hamuro80/deepstomp/hardware/deepstomp-cpu-board-stm32f1-blue-pill.png

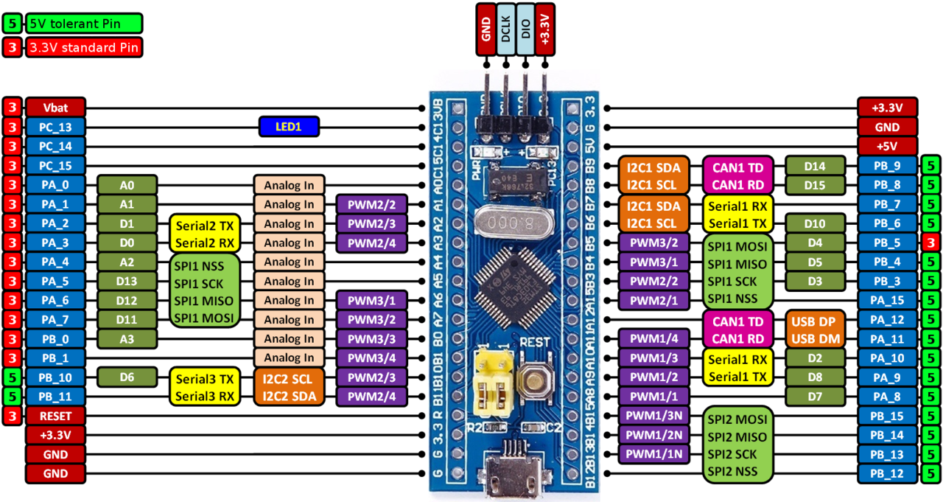
hardware/deepstomp-cpu-board-stm32f1-blue-pill.png
