hamuro80/deepstomp/hardware/deepstomp-main-board-schematic-1.2.png

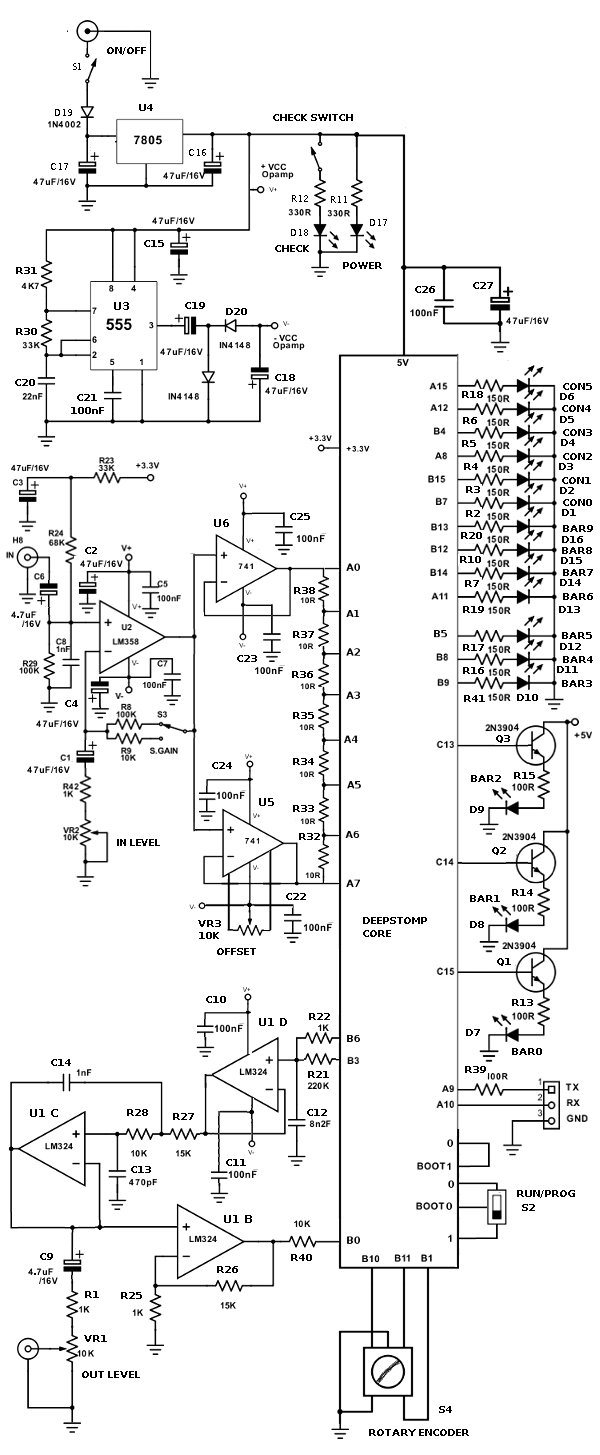
hardware/deepstomp-main-board-schematic-1.2.png
