hamuro80/deepstomp/software/deepstomp/Src/main.c

/**
  ******************************************************************************
  * @file           : main.c
  * @brief          : Main program body
  ******************************************************************************
  ** This notice applies to any and all portions of this file
  * that are not between comment pairs USER CODE BEGIN and
  * USER CODE END. Other portions of this file, whether 
  * inserted by the user or by software development tools
  * are owned by their respective copyright owners.
  *
  * COPYRIGHT(c) 2019 STMicroelectronics
  *
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
  ******************************************************************************
  */
/* Includes ------------------------------------------------------------------*/
#include "main.h"
#include "stm32f1xx_hal.h"

/* USER CODE BEGIN Includes */
/**
  ******************************************************************************
  * @file           : main.c
  * @brief          : Main core of DeepStomp program
  ******************************************************************************
  ** This notice applies to any and all portions of this file
  * that are  IN BETWEEN comment pairs USER CODE BEGIN and
  * USER CODE END. Other portions of this file, whether
  * inserted by the user or by software development tools
  * are owned by their respective copyright owners.
  *
  * Author: HAMURO
  * COPYRIGHT(c) 2018 DEEPTRONIC.COM
  *
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
  ******************************************************************************
  */
#include "deepstomp.h"
#include "dstlib_leveldetector.h"
#include "dstlib_dcremover.h"

//ENUMERATED CONSTANTS
enum {dsdisplaytype_bar, dsdisplaytype_dot, dsdisplaytype_blinkdot,dsdisplaytype_blinkbar,dsdisplaytype_semitones};
enum {editexit_expired,editexit_click,editexit_longpress,
	editexit_storepresetexpired,editexit_storepresetclick,
	editexit_storepresetlongpress};

//ERROR BLINK CODES
#define ERR_TOO_MANY_CAL_TRIALS	2
#define ERR_TOO_LOW_RESISTOR	3
#define ERR_TOO_HIGH_RESISTOR	4
#define ERR_STORAGE_ALLOCATION	5
#define ERR_MODULE_SETUP		6
#define ERR_DEBUGMON_INIT		7

//ROTARY
#define ROT_SW_Pin GPIO_PIN_1
#define ROT_SW_GPIO_Port GPIOB

#define ROT_PH_1_Pin GPIO_PIN_10
#define ROT_PH_1_GPIO_Port GPIOB
#define ROT_PH_0_Pin GPIO_PIN_11
#define ROT_PH_0_GPIO_Port GPIOB

//PARAMS LED
#define LED_INDI_0_Pin GPIO_PIN_7
#define LED_INDI_0_GPIO_Port GPIOB
#define LED_INDI_1_Pin GPIO_PIN_15
#define LED_INDI_1_GPIO_Port GPIOB
#define LED_INDI_2_Pin GPIO_PIN_8
#define LED_INDI_2_GPIO_Port GPIOA
#define LED_INDI_3_Pin GPIO_PIN_4
#define LED_INDI_3_GPIO_Port GPIOB
#define LED_INDI_4_Pin GPIO_PIN_12
#define LED_INDI_4_GPIO_Port GPIOA
#define LED_INDI_5_Pin GPIO_PIN_15
#define LED_INDI_5_GPIO_Port GPIOA

//LED BAR
#define LED_BAR_0_Pin GPIO_PIN_15
#define LED_BAR_0_GPIO_Port GPIOC
#define LED_BAR_1_Pin GPIO_PIN_14
#define LED_BAR_1_GPIO_Port GPIOC
#define LED_BAR_2_Pin GPIO_PIN_13
#define LED_BAR_2_GPIO_Port GPIOC
#define LED_BAR_3_Pin GPIO_PIN_9
#define LED_BAR_3_GPIO_Port GPIOB
#define LED_BAR_4_Pin GPIO_PIN_8
#define LED_BAR_4_GPIO_Port GPIOB
#define LED_BAR_5_Pin GPIO_PIN_5
#define LED_BAR_5_GPIO_Port GPIOB
#define LED_BAR_6_Pin GPIO_PIN_11
#define LED_BAR_6_GPIO_Port GPIOA
#define LED_BAR_7_Pin GPIO_PIN_14
#define LED_BAR_7_GPIO_Port GPIOB
#define LED_BAR_8_Pin GPIO_PIN_12
#define LED_BAR_8_GPIO_Port GPIOB
#define LED_BAR_9_Pin GPIO_PIN_13
#define LED_BAR_9_GPIO_Port GPIOB

//maximum CPU clock count for sample to sample acquisition
#define MAXCPUCOUNT	1632
//maximum CPU clock count for single sample processing to indicate CPU overload
#define MAXPROCESSINGCOUNT	1450
//CPU OVERLOAD DETECTOR
static uint8_t cpuoverload = 0;
static uint8_t cpuoverloadcounter = 0;

//ADC calibration
uint8_t CALIBRATIONMODE = 0;
//32766 + 128
#define maxcalsignallevel 32894
//32766 - 128
#define mincalsignallevel 32638
#define calsignalstep 2
//difference between onechannel and allchannel = 896
#define standarddiff 	896

//ADC calibration data
typedef struct
{
	uint16_t calsignalcurrlevel;
	int8_t calsignalstate;
	uint32_t allchannelsum ;
	uint32_t onechannelsum ;
	uint32_t onechannelsample;
	uint32_t allchannelsample;

	int8_t prevcalsignalstate;
	uint16_t mincalsample;
	uint16_t maxcalsample;
	uint16_t avgrange;
	uint32_t rangesum;
	uint32_t diffsum;
	int16_t diffavg;
	int avgcount;
} adccaldata;

typedef struct
{
	int32_t storagecounter;
	int8_t params[6];
	int8_t presetbuffer[800];	//4 params * 10 modules * 20 presets = 800
} storagestruct;

//preset data structure element
typedef struct
{
	int8_t control[4];
} controlarray;

//preset data structure element
typedef struct
{
	controlarray module[10];
} modulearray;

typedef struct
{
	modulearray preset[19];
} preset;

//debug monitor data
typedef struct
{
	char txbuff[533];
	char rxbuff[40];
	int rxbuffindex;
	int rxbuffsize;
	unsigned char rxchar;
	char* display;
	char* debugtext;
	int displaysize;
	char linebuffer[51];
	volatile uint8_t serialtxcomplete;
	long int debugvars[4];

	q15_t levelprobes[2];
	q15_t levelout[2];
	dst_leveldetector_handle levelprobe1;
	dst_leveldetector_handle levelprobe2;

	uint32_t run_prevtick;
	uint32_t run_currtick;

} debugmonitor;


enum {tunerfillstate_start,tunerfillstate_waitlow,tunerfillstate_waitrising,
	tunerfillstate_waitfalling,tunerfillstate_waitsecondrising,
	tunerfillstate_placetobin,tunerfillstate_findthenote,tunerfillstate_idle};
//Scaled 8x (one-period sample count)  of C to B semitone notes (65.41Hz - 123.47Hz)
uint32_t const periodcountcenter8x[] =
{5394,5091,4805,4536,4281,4041,3814,3600,3398,3207,3027,2857};

//period count at semitone boundary
uint32_t const periodcountboundary8x[] =
{5552,5240,4946,4669,4407,4159,3926,3706,3498,3301,3116,2941,2776};

typedef struct
{
	uint8_t detectednote;
	int8_t notedeviation;
	uint8_t audiomute;
	uint32_t periodcounter;
	uint32_t previousperiod;
	uint32_t accumulatedperiod;
	uint16_t accumulatedcycle;
	uint16_t nosignalcounter;
	uint8_t fillstate;
	uint16_t detectionlength;
	q15_t positivethreshold;
	q15_t negativethreshold;
	uint16_t peakdetectcounter;
	uint8_t peakdetectstate;
	q15_t pospeak0;
	q15_t pospeak1;
	q15_t negpeak0;
	q15_t negpeak1;
	uint32_t run_prevtick;
	uint32_t run_currtick;
	uint8_t run_state;
} instrumenttuner;

/* USER CODE END Includes */

ADC_HandleTypeDef hadc1;
ADC_HandleTypeDef hadc2;
DMA_HandleTypeDef hdma_adc1;

TIM_HandleTypeDef htim1;
TIM_HandleTypeDef htim2;
TIM_HandleTypeDef htim3;
TIM_HandleTypeDef htim4;

UART_HandleTypeDef huart1;
DMA_HandleTypeDef hdma_usart1_tx;

/* USER CODE BEGIN PV */
//Debug monitor
debugmonitor* dmon;

	//double pwm calibration variables
	uint16_t histep=0;
	uint16_t lostep=0;
	int calibcount=0;


	//ADC calibration data
	adccaldata* caldata;

	//musical instrument  tuner
	instrumenttuner* tuner;
	uint8_t tunermode = 0;

	//audio input-output variables
	q15_t INPUTLEVEL;	//the detected input level before any processing by effect application
	uint16_t adcbuffer[16];
	q15_t insample=0;
	q15_t outsample=0;
	int adccounter=0;
	uint16_t cpucount=0;
	q15_t paramlevel;
	dst_leveldetector_handle leveldetector;
	dst_dcremover_handle dcremover;
	uint32_t RUNTIME=0;

	//parameter edit control
	//handle of the edited module (PARAMS[0]-PARAMS[3] in multi-effect mode
	dsthandle SUBMODULE;
	dstparam* PARAMS[6];	//The attached parameters (to be rotated and edited)
	int8_t EDITEXITSTATUS;	//the status of PARAMS edit mode exit
	static int8_t paramindex;
	static int8_t presettostore;
	static paramchangecall ROTATE_CALLBACK = 0;
	static uint32_t ROTATEDMODULE = 0;
	dstparam paramdump;

	//parameter saving variables
	//assume a 64k flash memory, use the last four pages  for params and presets storage (page address 0x800f00 to 0x800fc00)
	uint32_t* storagepageaddress[] = {(uint32_t*)0x800f000,(uint32_t*)0x800f400,(uint32_t*)0x800f800,(uint32_t*)0x800fc00};
	storagestruct* storagebuffer;
	int activepageindex;
	int32_t storagecounter;
	int datasetlength;
	int datasetindex;
	int8_t requeststorageupdate=0;
	preset* PRESETBUFFER;	//preset buffer pointer

	//led indicator and led bar constants
	//led indicator states buffer
	uint8_t ledindibuttonstate[] = {0,0,0,0,0,0};	//when activated by toggle or radio button

const GPIO_TypeDef* ledbarport[] = {LED_BAR_0_GPIO_Port,LED_BAR_1_GPIO_Port,LED_BAR_2_GPIO_Port,
		LED_BAR_3_GPIO_Port,LED_BAR_4_GPIO_Port,LED_BAR_5_GPIO_Port,
		LED_BAR_6_GPIO_Port,LED_BAR_7_GPIO_Port,LED_BAR_8_GPIO_Port,
		LED_BAR_9_GPIO_Port};
const uint16_t ledbarpin[] = {LED_BAR_0_Pin,LED_BAR_1_Pin,LED_BAR_2_Pin,LED_BAR_3_Pin,
		LED_BAR_4_Pin,LED_BAR_5_Pin,LED_BAR_6_Pin,LED_BAR_7_Pin,
		LED_BAR_8_Pin,LED_BAR_9_Pin};
const GPIO_TypeDef* ledindiport[] = {LED_INDI_0_GPIO_Port,LED_INDI_1_GPIO_Port,
		LED_INDI_2_GPIO_Port,LED_INDI_3_GPIO_Port,LED_INDI_4_GPIO_Port,LED_INDI_5_GPIO_Port};
const uint16_t ledindipin[] = {LED_INDI_0_Pin,LED_INDI_1_Pin,LED_INDI_2_Pin,
		LED_INDI_3_Pin,LED_INDI_4_Pin,LED_INDI_5_Pin};

/* USER CODE END PV */

void SystemClock_Config(void);
static void MX_GPIO_Init(void);
static void MX_DMA_Init(void);
static void MX_ADC1_Init(void);
static void MX_ADC2_Init(void);
static void MX_TIM3_Init(void);
static void MX_USART1_UART_Init(void);
static void MX_TIM4_Init(void);
static void MX_TIM2_Init(void);
static void MX_TIM1_Init(void);

void HAL_TIM_MspPostInit(TIM_HandleTypeDef *htim);
                                

/* USER CODE BEGIN PFP */
static void errorhalt(int blinkcount);
static void errorblink(int blinkcount);
static uint16_t generatecalsignal();
static void runcalibrationdisplay();
static int debugmonitor_init();
static void debugmonitor_run();
static void debugdisplay(char* string, int line);
void createleveprobe(char* buff,q15_t level,char* label);
void adccal_init();
void tuner_init();
void tuner_fillnotebins(q15_t* input);
void tuner_detectpeak(q15_t* input);
void tuner_run();


/* USER CODE END PFP */

/* USER CODE BEGIN 0 */

enum {tuner_runstate_start,tuner_runstate_waitfill,tuner_runstate_setdisplay};
void tuner_run()
{
	tuner->run_currtick = HAL_GetTick();
	if((tuner->run_currtick - tuner->run_prevtick) < 2) // execute every 2 milliseconds
		return;

	tuner->run_prevtick = tuner->run_currtick;
	switch(tuner->run_state)
	{
		case tuner_runstate_start:
		{
			tuner->fillstate = tunerfillstate_start;
			tuner->run_state = tuner_runstate_waitfill;
			break;
		}
		case tuner_runstate_waitfill:
		{
			if(tuner->fillstate == tunerfillstate_idle)
				tuner->run_state = tuner_runstate_setdisplay;
			break;
		}
		case tuner_runstate_setdisplay:
		{
			if(tuner->accumulatedcycle > 0)
			{
				int32_t averageperiod = (tuner->accumulatedperiod<<3)/ tuner->accumulatedcycle;

				//normalize the period to the standard octave
				while(averageperiod > periodcountboundary8x[0])
					averageperiod = averageperiod >> 1;
				while(averageperiod < periodcountboundary8x[12])
					averageperiod = averageperiod << 1;

				for(uint8_t i=1;i<13;i++)
				{
					if(averageperiod > periodcountboundary8x[i])
					{
						tuner->detectednote = i-1;
						break;
					}
				}
				debugSetVar(averageperiod,0);
				debugSetVar(tuner->accumulatedcycle,1);
				debugSetVar(tuner->detectednote,2);

				//set the deviation display
				tuner->notedeviation = 0;
				int32_t ndev = averageperiod - periodcountcenter8x[tuner->detectednote];
				int downstep = (periodcountboundary8x[tuner->detectednote]-
								periodcountcenter8x[tuner->detectednote])/3;
				int upstep = (periodcountcenter8x[tuner->detectednote]
								- periodcountboundary8x[1+tuner->detectednote])/3;

				//translate the detected note to differentiate mute and unmuted operation
				if(tuner->audiomute)
					tuner->detectednote += 12;
				else tuner->detectednote += 24;

				//first turn off all note deviation indicator leds
				for(int i=0;i<6;i++)
					ledindibuttonstate[i]=0;

				//if deviate above the center frequency
				if(ndev < 0)
				{
					int upindex = -ndev/downstep;
					if(upindex >2) upindex = 2;
					ledindibuttonstate[3+upindex]=1;

					//if only slightly above the center
					if(ndev > (- upstep>>1))
						ledindibuttonstate[2]=1;

				}
				else if(ndev>0) //if deviate below the center frequency
				{
					int downindex = ndev/downstep;
					if(downindex >2) downindex = 2;
					ledindibuttonstate[2-downindex]=1;

					//if only slightly above the center
					if(ndev < (upstep>>1))
						ledindibuttonstate[3]=1;
				}
				else	//if not deviate
				{
					ledindibuttonstate[3]=1;
					ledindibuttonstate[2]=1;
				}

				//reset nosignal counter
				tuner->nosignalcounter = 0;

			}
			else	//no signal detected
			{
				//turn off all note deviation indicator leds
				if(tuner->nosignalcounter<11)
					tuner->nosignalcounter++;
				if(tuner->nosignalcounter>5) //more than 1 second
				{
					for(int i=0;i<6;i++)
					{
						ledindibuttonstate[i]=0;
					}
				}
			}

			tuner->run_state = tuner_runstate_start;
			break;
		}
	}
}

void tuner_init()
{
	tuner = malloc(sizeof(tuner));
	tuner->detectednote = 24;
	tuner->notedeviation = -4;
	tuner->audiomute = 0;
	tuner->run_state = tuner_runstate_start;
	tuner->run_prevtick = 0;
	tuner->run_prevtick = 0;
	tuner->fillstate = tunerfillstate_idle;
	tuner->peakdetectcounter = 0;
	tuner->peakdetectstate = 0;
	tuner->pospeak0 = 0;
	tuner->pospeak1 = 0;
	tuner->negpeak0 = 0;
	tuner->negpeak1 = 0;
	tuner->nosignalcounter = 0;
}

void tuner_detectpeak(q15_t* input)
{
	tuner->peakdetectcounter++;
	q15_t positivepeak,negativepeak;
	if(tuner->peakdetectstate == 0)
	{
		if((*input)>tuner->pospeak0) tuner->pospeak0 = (*input);
		if((*input)<tuner->negpeak0) tuner->negpeak0 = (*input);
		if(tuner->peakdetectcounter > 2205)
		{
			tuner->peakdetectcounter = 0;
			tuner->peakdetectstate = 1;
			if(tuner->pospeak0 > tuner->pospeak1)
				positivepeak = tuner->pospeak0;
			else positivepeak = tuner->pospeak1;
			if(tuner->negpeak0 < tuner->negpeak1)
				negativepeak = tuner->negpeak0;
			else negativepeak = tuner->negpeak1;

			tuner->positivethreshold = (q15_t) ((q31_t)(positivepeak << 3)/10);
			tuner->negativethreshold = (q15_t) ((q31_t)(negativepeak << 3)/10);

			tuner->pospeak1 = 0;
			tuner->negpeak1 = 0;


		}
	}
	else
	{
		if((*input)>tuner->pospeak1) tuner->pospeak1 = (*input);
		if((*input)<tuner->negpeak1) tuner->negpeak1 = (*input);
		if(tuner->peakdetectcounter > 2205)
		{
			tuner->peakdetectcounter = 0;
			tuner->peakdetectstate = 0;

			//select the maximum minimum
			if(tuner->pospeak0 > tuner->pospeak1)
				positivepeak = tuner->pospeak0;
			else positivepeak = tuner->pospeak1;
			if(tuner->negpeak0 < tuner->negpeak1)
				negativepeak = tuner->negpeak0;
			else negativepeak = tuner->negpeak1;

			tuner->positivethreshold = (q15_t) ((q31_t)(positivepeak << 3)/10);
			tuner->negativethreshold = (q15_t) ((q31_t)(negativepeak << 3)/10);

			//reset the variable for the next phase
			tuner->pospeak0 = 0;
			tuner->negpeak0 = 0;
		}
	}
}

void tuner_fillnotebins(q15_t* input)
{
	tuner_detectpeak(input);
	switch(tuner->fillstate)
	{
		case tunerfillstate_start:
		{
			tuner->detectionlength = 0;
			tuner->accumulatedcycle = 0;
			tuner->accumulatedperiod = 0;
			tuner->negativethreshold = 0;
			tuner->positivethreshold = 0;
			tuner->fillstate = tunerfillstate_waitlow;
			break;
		}
		case tunerfillstate_waitlow:
		{
			if((tuner->positivethreshold > 500) && ((*input)<0))
				tuner->fillstate = tunerfillstate_waitrising;
			break;
		}
		case tunerfillstate_waitrising:
		{
			if((*input)>tuner->positivethreshold)
			{
				tuner->periodcounter = 0;
				tuner->fillstate = tunerfillstate_waitfalling;
			}
			break;
		}
		case tunerfillstate_waitfalling:
		{
			tuner->periodcounter++;
			if((*input) < tuner->negativethreshold)
				tuner->fillstate = tunerfillstate_waitsecondrising;
			break;
		}
		case tunerfillstate_waitsecondrising:
		{
			tuner->periodcounter++;
			if((*input) > tuner->positivethreshold)
			{
				//filter the detected period
				//if periodcounter differs not more than on semitone than previous then
				//accumulate the period and update the previous with the new period
				//if differs more that one semitones (6%) then update the previous with
				//the new one and discard the mesured period

				//if between 20-2000Hz
				if((tuner->periodcounter > 20)&&(tuner->periodcounter<2200))
				{
					int32_t perioddiff ;
					if(tuner->periodcounter > tuner->previousperiod)
							perioddiff = (tuner->periodcounter - tuner->previousperiod)<<10;
					else  perioddiff = (tuner->previousperiod - tuner->periodcounter)<<10;

					if((perioddiff/tuner->previousperiod) <= 61)	//if not differ more than one semitone
					{
						tuner->accumulatedcycle++;
						tuner->accumulatedperiod += tuner->periodcounter;
					}
					tuner->previousperiod = tuner->periodcounter;
				}

				//reset period counter
				tuner->periodcounter = 0;
				tuner->fillstate = tunerfillstate_waitfalling;
			}
			break;
		}
		case tunerfillstate_idle:
		{
			break;
		}

	}

	if(tuner->fillstate != tunerfillstate_idle)
		tuner->detectionlength++;
	if(tuner->detectionlength > 8820)	// more than 0.2 seconds
		tuner->fillstate = tunerfillstate_idle; //stop the detection
}

int debugmonitor_init()
{
	dmon = malloc(sizeof(debugmonitor));
	if(dmon==NULL)
		return ERR_DEBUGMON_INIT;
	dmon->txbuff[0]=27;
	dmon->txbuff[1] ='[';
	dmon->txbuff[2] = 'H';
	dmon->display = &(dmon->txbuff[3]);
	dmon->debugtext = "DEBUG TEXT";
	dmon->serialtxcomplete = 1;
	dmon->rxbuffindex = 0;
	dmon->rxbuffsize = 40;
	dmon->displaysize = 530;

	for(int i=3;i<533;i++)
	{
		dmon->txbuff[i]=' ';
	}
	dmon->txbuff[532]=0;

	for(int i=50;i<530;i++)
	{
	  if((i%53)==0)
	  {
		  dmon->display[i-2]='\n';
		  dmon->display[i-1]='\r';
	  }
	}

	debugdisplay("DEEPSTOMP PEDAL PROCESSOR DEBUG MONITOR",0);
	if(USE_LEVEL_MONITOR)
	{
		dmon->levelprobe1 = dst_leveldetector_create(4410);
		dmon->levelprobe2 = dst_leveldetector_create(4410);
	}
	return 0;
}

static void debugdisplay(char* string, int line)
{
	if(line>9)
		return;
	char* dest = &(dmon->display[53*line]);
	strncpy(dest,string,50);
	int len = strlen(string);
	if(len>50)
		len=50;
	for(int i=len;i<50;i++)
		dest[i]=' ';	//overwrite the old data with space
}

void debugSetText(char* text)
{
	if(USE_DEBUG_MONITOR)
	{
		dmon->debugtext = text;
	}
}

void debugmonitor_run()
{
	dmon->run_currtick = HAL_GetTick();
	if(dmon->run_currtick-dmon->run_prevtick<100)
	  return;
	dmon->run_prevtick = dmon->run_currtick;
	int sr = adccounter * 10;
	adccounter = 0;

	snprintf(dmon->linebuffer,51,"Run: %d s, sfreq: %d, storage cycles: %ld",(int)dmon->run_currtick/1000,sr,storagecounter);
	debugdisplay(dmon->linebuffer,1);
	snprintf(dmon->linebuffer,51,"CAL (Hi: %d, Low: %d, ARR2: %d, Trial: %d)",(int)histep,(int)lostep,(int)TIM2->ARR,(int)calibcount);
	debugdisplay(dmon->linebuffer,2);
	if(cpucount==0)	//CPU overload
		snprintf(dmon->linebuffer,51,"Module CPU: OVERLOAD");
	else
	{
		snprintf(dmon->linebuffer,51,"Module CPU: %d%%",100*cpucount/MAXCPUCOUNT);
	}
	debugdisplay(dmon->linebuffer,3);

	if(USE_LEVEL_MONITOR)
	{
		createleveprobe(dmon->linebuffer,INPUTLEVEL,"IN");
		debugdisplay(dmon->linebuffer,4);
		createleveprobe(dmon->linebuffer,dmon->levelout[0],"P1");
		debugdisplay(dmon->linebuffer,5);
		createleveprobe(dmon->linebuffer,dmon->levelout[1],"P2");
		debugdisplay(dmon->linebuffer,6);
		if(CALIBRATIONMODE)
			snprintf(dmon->linebuffer,51,"ADC CAL: Range, One Ch., All Ch., Diff");
		else snprintf(dmon->linebuffer,51,"DTXT: %s",dmon->debugtext);
		debugdisplay(dmon->linebuffer,7);
		snprintf(dmon->linebuffer,51,"DVAR: %ld, %ld, %ld, %ld",
		  dmon->debugvars[0],dmon->debugvars[1],
		  dmon->debugvars[2],dmon->debugvars[3]);

		debugdisplay(dmon->linebuffer,8);
	}
	else
	{
		if(CALIBRATIONMODE)
			snprintf(dmon->linebuffer,51,"ADC CAL: Range, One Ch., All Ch., Diff");
		else snprintf(dmon->linebuffer,51,"DTXT: %s",dmon->debugtext);
		debugdisplay(dmon->linebuffer,4);
		snprintf(dmon->linebuffer,51,"DVAR: %ld,%ld, %ld, %ld",
		  dmon->debugvars[0],dmon->debugvars[1],
		  dmon->debugvars[2],dmon->debugvars[3]);
		debugdisplay(dmon->linebuffer,5);
	}

	//return if DMA transfer is still working
	if(dmon->serialtxcomplete == 0)
	  return;
	//reset the flag and start DMA transmit
	dmon->serialtxcomplete = 0;
	HAL_UART_Transmit_DMA(&huart1,(uint8_t*)dmon->txbuff,512);
}

void debugSetVar(int32_t var, uint8_t index)
{
	if(index>3)index = 3;
	if(USE_DEBUG_MONITOR)
	{
		dmon->debugvars[index]=var;
	}
}
void debugDetectLevel(q15_t signal, uint8_t channel)
{
	dmon->levelprobes[channel] = signal;
}

void adccal_init()
{
	caldata = malloc(sizeof(caldata));
	caldata->allchannelsum=0;
	caldata->avgcount = 0;
	caldata->avgrange = 0;
	caldata->calsignalcurrlevel = mincalsignallevel;
	caldata->calsignalstate = 1;
	caldata->diffavg = 0;
	caldata->diffsum = 0;
	caldata->maxcalsample = 0;
	caldata->mincalsample = 65000;
	caldata->onechannelsum = 0;
	caldata->prevcalsignalstate = 1;
	caldata->rangesum = 0;
}

static void runcalibrationdisplay()
{
	// if the sawtooth generator change the direction from down ramp to up ramp
	// (changes every 128 steps, 64 steps up and 64 steps down)
	// the input might have a phase shift but it would always be a complete cycle
	if((caldata->calsignalstate==1)&&(caldata->prevcalsignalstate==0))
	{
		caldata->rangesum += (caldata->maxcalsample-caldata->mincalsample);	//sums for averaging
		caldata->diffsum += caldata->allchannelsum-caldata->onechannelsum;		//difference between all and one channel
		caldata->avgcount++;
		if(caldata->avgcount==128)
		{
			caldata->avgrange = caldata->rangesum >> 7;	//the average range should 128 if the i/o level is properly adjusted
			caldata->rangesum = 0;
			caldata->avgcount = 0;
			caldata->diffavg = (int16_t) ( caldata->diffsum >> 7);
			/*the average difference between all and one channel should be 896
			 * when the all channel is produced by 15bit ADC and the one channel is produced by (12bit_ADC << 3)
			 */
			caldata->diffsum = 0;
		    if(USE_DEBUG_MONITOR)
		    {
		    	dmon->debugvars[0] = (int) caldata->avgrange;
		    	dmon->debugvars[1] = (int) caldata->onechannelsum;
				dmon->debugvars[2] = (int) caldata->allchannelsum;
				dmon->debugvars[3] = (int) caldata->diffavg;
		    }
		}

		//display avgrange on the 6-LED-bar, diffavg=128 for the center point
		//activate 2-LEDs only for the center point
	    int insignalindex = (caldata->avgrange>>3)-14;
	    if(insignalindex < 0) insignalindex = 0;
	    if(insignalindex > 4) insignalindex = 4;
	    for(int i = 0;i<5;i++)
	    {
	    	int offset = 0;
	    	if(i>=3) offset = 1;
	    	HAL_GPIO_WritePin((GPIO_TypeDef*)ledindiport[i+offset],ledindipin[i+offset],i==insignalindex);
	    	if(i==2)
	    		HAL_GPIO_WritePin((GPIO_TypeDef*)ledindiport[3],ledindipin[3],i==insignalindex);
	    }

	    //display diffavg on the 10-LED-bar, diffavg=896 for the center point
	    //activate 2-LEDs only for the center point
	    insignalindex = ( caldata->diffavg >> 7 ) - 3;
		if(insignalindex < 0) insignalindex = 0;
		if(insignalindex > 9) insignalindex = 8;
		for(int i = 0;i<9;i++)
		{
			int offset = 0;
			if(i>=5) offset = 1;
			HAL_GPIO_WritePin((GPIO_TypeDef*)ledbarport[i+offset],ledbarpin[i+offset],i==insignalindex);
			if(i==4)
				HAL_GPIO_WritePin((GPIO_TypeDef*)ledbarport[5],ledbarpin[5],i==insignalindex);
		}

		caldata->onechannelsum = 0;
		caldata->allchannelsum = 0;
		caldata->mincalsample = 65534;
		caldata->maxcalsample = 0;
	}

	caldata->prevcalsignalstate = caldata->calsignalstate;
	if(caldata->onechannelsample > caldata->maxcalsample)
		caldata->maxcalsample = caldata->onechannelsample;
	if(caldata->onechannelsample < caldata->mincalsample)
		caldata->mincalsample = caldata->onechannelsample;

}


void loadfromstorage()
{
	//read the flash memory
	uint32_t* bufferptr = (uint32_t*) storagebuffer;

	storagecounter = 0;
	int maxindex = 0;
	for(int i=0;i<4;i++)
	{
		int32_t* counterptr = (int32_t*)storagepageaddress[i];
		if(counterptr[0] > storagecounter)
		{
			storagecounter = counterptr[0];
			maxindex = i;
		}
	}
	activepageindex = maxindex;

	//load from maxindex page
	uint32_t* storageptr = storagepageaddress[maxindex];
	for(uint16_t i=0;i<256;i++)
	{
		bufferptr[i] = storageptr[i];
	}
}

void writetostorage()
{
	requeststorageupdate=1;
}

uint32_t storagewrite_currtick = 0;
uint32_t storagewrite_prevtick = 0;
int storagewriteindex;
enum {writestate_wait,writestate_selectpage,writestate_erase,writestate_program};
uint8_t writestate = writestate_wait;
static void runstoragewrite()
{
	storagewrite_currtick = HAL_GetTick();
	if(storagewrite_currtick-storagewrite_prevtick<10)
		return;
	storagewrite_prevtick = storagewrite_currtick;

	switch(writestate)
	{
		case writestate_wait:
		{
			if(requeststorageupdate)
			{
				requeststorageupdate=0;
				storagewriteindex = 0;
				writestate= writestate_selectpage;
			}
			break;
		}
		case writestate_selectpage:
		{
			//unlock the flash
			HAL_FLASH_Unlock();

			uint32_t* data = (uint32_t*) storagebuffer;
			storagecounter++;
			data[0] = storagecounter;

			//select the next page for the next storage to increase total storage durability
			activepageindex++;
			if(activepageindex>3)
				activepageindex = 0;
			writestate = writestate_erase;
			break;
		}
		case writestate_erase:
		{
			//erase the page
			FLASH_EraseInitTypeDef eraseinit;
			eraseinit.PageAddress = (uint32_t)storagepageaddress[activepageindex];
			eraseinit.Banks = FLASH_BANK_1;
			eraseinit.NbPages = 1;
			eraseinit.TypeErase = FLASH_TYPEERASE_PAGES;
			uint32_t pageerror;
			HAL_FLASHEx_Erase(&eraseinit,&pageerror);
			writestate = writestate_program;
			break;
		}
		case writestate_program:
		{
			//write the page
			uint32_t* data = (uint32_t*) storagebuffer;
			HAL_FLASH_Program(FLASH_TYPEPROGRAM_WORD,(uint32_t) &(storagepageaddress[activepageindex][storagewriteindex]),(uint64_t)data[storagewriteindex]);

			//increment the index and lock the page if done
			storagewriteindex++;
			if(storagewriteindex==256)
			{
				HAL_FLASH_Lock();
				writestate = writestate_wait;
			}
			break;
		}
	}

}

static void errorhalt(int blinkcount)
{
	//turn off all LEDs
	for(int i=0;i<6;i++)
	{
		HAL_GPIO_WritePin((GPIO_TypeDef*)ledbarport[i],ledindipin[i],0);
	}
	for(int i=0; i<10; i++)
	{
		HAL_GPIO_WritePin((GPIO_TypeDef*)ledbarport[i],ledbarpin[i],0);
	}

	//long 2 seconds fast blinks first
	for(int i=0;i<20;i++)
	{
		HAL_GPIO_WritePin((GPIO_TypeDef*)ledindiport[0],ledindipin[0],1);
		HAL_Delay(50);
		HAL_GPIO_WritePin((GPIO_TypeDef*)ledindiport[0],ledindipin[0],0);
		HAL_Delay(50);
	}

	//period
	HAL_Delay(1000);

	//then blink forever
	while(1)
	{
		for(int i=0;i<blinkcount;i++)
		{
			HAL_GPIO_WritePin((GPIO_TypeDef*)ledindiport[0],ledindipin[0],1);
			HAL_Delay(250);
			HAL_GPIO_WritePin((GPIO_TypeDef*)ledindiport[0],ledindipin[0],0);
			HAL_Delay(250);
		}
		HAL_Delay(500);
	}
}

static void errorblink(int blinkcount)
{
	//turn off all LEDs
	for(int i=0;i<6;i++)
	{
		HAL_GPIO_WritePin((GPIO_TypeDef*)ledbarport[i],ledindipin[i],0);
	}
	for(int i=0; i<10; i++)
	{
		HAL_GPIO_WritePin((GPIO_TypeDef*)ledbarport[i],ledbarpin[i],0);
	}

	//long 2 seconds fast blinks first
	for(int i=0;i<20;i++)
	{
		HAL_GPIO_WritePin((GPIO_TypeDef*)ledindiport[0],ledindipin[0],1);
		HAL_Delay(50);
		HAL_GPIO_WritePin((GPIO_TypeDef*)ledindiport[0],ledindipin[0],0);
		HAL_Delay(50);
	}

	//period
	HAL_Delay(1000);

	//then blinks the error code
	for(int i=0;i<blinkcount;i++)
	{
		HAL_GPIO_WritePin((GPIO_TypeDef*)ledindiport[0],ledindipin[0],1);
		HAL_Delay(500);
		HAL_GPIO_WritePin((GPIO_TypeDef*)ledindiport[0],ledindipin[0],0);
		HAL_Delay(500);
	}
}

//digital anti aliasing filter at 20kHz cut-off frequency
#define antialiasingGAIN   1259
static q31_t xv[3], yv[3];
static void antialiasing(q15_t *input, q15_t* output)
{
	xv[0] = xv[1];
	xv[1] = xv[2];
	xv[2] = ((q31_t)(*input)<<10) / antialiasingGAIN;
	yv[0] = yv[1];
	yv[1] = yv[2];
	yv[2] =   (((xv[0] + xv[2]) + 2 * xv[1])<<10)
				 + ( -678 * yv[0]) + ( -1629 * yv[1]);
	yv[2] = yv[2] >> 10;
	*output = (q15_t) yv[2];
}

static void initantialiasing()
{
	for(int i=0;i<3;i++)
	{
		xv[i]=0;
		yv[i]=0;
	}
}

GPIO_PinState  readrotsw()
{
	return HAL_GPIO_ReadPin(ROT_SW_GPIO_Port,ROT_SW_Pin);
}

GPIO_PinState  readrotp0()
{
	return HAL_GPIO_ReadPin(ROT_PH_0_GPIO_Port,ROT_PH_0_Pin);
}

GPIO_PinState  readrotp1()
{
	return HAL_GPIO_ReadPin(ROT_PH_1_GPIO_Port,ROT_PH_1_Pin);
}

int8_t rotscancount = 0;
int8_t rotsw = 1;
int8_t rotp0 = 1;
int8_t rotp1 = 1;

int8_t rotsw_sum = 0;
int8_t rotp0_sum = 0;
int8_t rotp1_sum = 0;
uint32_t rotscan_currtick = 0;
uint32_t rotscan_prevtick = 0;
void rotscan()
{
	rotscan_currtick = HAL_GetTick();
	if(rotscan_currtick-rotscan_prevtick<1)
		return;
	rotscan_prevtick = rotscan_currtick;
	rotsw_sum += (int8_t)readrotsw();
	rotp0_sum += (int8_t)readrotp0();
	rotp1_sum += (int8_t)readrotp1();
	rotscancount++;
	if(rotscancount>9)
	{
		rotscancount = 1;
		if(rotsw_sum>5) rotsw = 1; else rotsw = 0;
		if(rotp0_sum>5) rotp0 = 1; else rotp0 = 0;
		if(rotp1_sum>5) rotp1 = 1; else rotp1 = 0;
		rotsw_sum = 0;
		rotp0_sum = 0;
		rotp1_sum = 0;
	}
}

static uint8_t prevrotp0,prevrotsw;
enum {rotencode_idle,rotencode_startwaittrigger,rotencode_waittrigger,
	rotencode_startrun,rotencode_run,rotencode_waitrelease};
static uint8_t rotencode_state = rotencode_idle;
static uint32_t rotencode_currtick = 0;
static uint32_t rotencode_prevtick = 0;
uint8_t rotwaitexit = 0;
static int8_t* rotatedindex = 0;
static int8_t rotatedindexmax = 0;
static int8_t rotatetrigger = 0;
static int8_t longpresstrigger = 0;
static int8_t briefpresstrigger = 0;
enum {rotateexit_notyet,rotateexit_click,rotateexit_expired,
	rotateexit_hold,rotateexit_longpress};
static int8_t rotateexit = rotateexit_notyet;
static int rotateidle;
static int rotateholdcounter;
static int holdcounter;
static int8_t rotate_editparam = 0;

void rotencode()
{
	rotencode_currtick = HAL_GetTick();
	if(rotencode_currtick-rotencode_prevtick<10)
		return;
	rotencode_prevtick = rotencode_currtick;

	if(rotencode_state == rotencode_startwaittrigger)
	{
		rotatetrigger = 0;
		longpresstrigger = 0;
		briefpresstrigger = 0;
		if(rotp0 && rotsw)
			rotencode_state = rotencode_waittrigger;
	}
	else if(rotencode_state == rotencode_waittrigger)
	{
		if(!rotsw)	//if pressed
		{
			rotencode_state = rotencode_waitrelease;
			holdcounter = 0;
		}
		else if(rotp0 && (!prevrotp0))
		{
			rotatetrigger = 1;
			rotencode_state = rotencode_idle;
		}
	}
	else if(rotencode_state == rotencode_waitrelease)
	{
		if(!rotsw)	//if pressed
		{
			holdcounter++;
			if(holdcounter>100)
			{
				longpresstrigger = 1;
				rotencode_state = rotencode_idle;
			}
		}
		else	//if released
		{
			briefpresstrigger = 1;
			rotencode_state = rotencode_idle;
		}
	}
	else if(rotencode_state == rotencode_startrun)
	{
		rotateexit = rotateexit_notyet;
		if(rotsw && rotp0)
		{
			rotencode_state = rotencode_run;
			rotateidle = 0;
		    rotateholdcounter = 0;
		}
	}
	else if(rotencode_state == rotencode_run)
	{
		if(rotateexit == rotateexit_notyet)
		{
			if(rotsw)
			{
				if((rotp0==0)&& prevrotp0)
				{
					int8_t newval = *rotatedindex;

					if(rotp1)
					{
						newval++;
						if(newval > rotatedindexmax)
							newval = rotatedindexmax;
					}
					else
					{
						newval --;
						if(newval < 0)
							newval = 0;
					}
					rotateidle = 0;

					if(rotate_editparam)	//editing param's value
					{
						if(ROTATE_CALLBACK)
						{
							ROTATE_CALLBACK(ROTATEDMODULE,newval);
						}
						else *rotatedindex = newval;
					}
					else // selecting params
					{
						// if PARAMS[newval] has stepcount > 1 then rotatedindex = newval
						// else then increment/decrement newval until PARAMS[newval] has stepcount > 1
						// or reaching the boundary (0-5)
						if(PARAMS[newval]->stepcount > 1)
						{
							*rotatedindex = newval;
						}
						else
						{
							int direction = 1;
							if(newval < *rotatedindex)
								direction = -1;
							while(1)
							{
								if((newval == 0)||(newval == 5))
									break;

								newval = newval + direction;
								if(PARAMS[newval]->stepcount > 1)
								{
									(*rotatedindex) = newval;
									break;
								}
							}
						}

						ROTATEDMODULE = MAINMODULE;
						if(((dstinterface*)MAINMODULE)->multimode)
							if((*rotatedindex) < 4) ROTATEDMODULE = SUBMODULE;
					}

				}
				else	//no rotation
				{
					rotateidle++;
					if(rotateidle > 400)
						rotateexit = rotateexit_expired;
				}
			}
			else //rotary switch is pressed
			{
				rotateexit = rotateexit_hold;
			}

		}
		else if(rotateexit == rotateexit_hold)
		{
			if(rotsw)
			{
				if(rotateholdcounter>100)	// 1 second
				{
					rotateexit = rotateexit_longpress;
				}
				else rotateexit = rotateexit_click;
			}
			else
			{
				rotateholdcounter++;
				if(rotateholdcounter>100)
					rotateexit = rotateexit_longpress;
			}
		}
	}
	prevrotp0 = rotp0;
	prevrotsw = rotsw;
}

void HAL_ADC_ConvCpltCallback(ADC_HandleTypeDef* hadc)
{
	 TIM1->CNT = 0;
	 adccounter++;
	 if(cpucount > MAXPROCESSINGCOUNT) //CPU overload is detected on previous processing
	 {
		 cpucount = 0;
		 cpuoverload = 1;
		 return;
	 }

	 if(CALIBRATIONMODE)	//adc calibration mode
	 {
		 int32_t temp=0;
		 for(int i=8; i<16;i++)
		 {
			 temp += adcbuffer[i];
		 }

		 //record the sum of both single and multi-channel
		 caldata->onechannelsample = (((uint32_t)adcbuffer[8]) << 3);
		 caldata->onechannelsum += caldata->onechannelsample;
		 caldata->allchannelsample = temp;
		 caldata->allchannelsum += caldata->allchannelsample;

		 //run calibration display
		 runcalibrationdisplay();

		 //write calibration signal to the output
		 temp = (int32_t) generatecalsignal();
		 TIM4->CCR1 = (0xff00 & temp)>>8;
		 TIM2->CCR2 = 0xff & temp;
		 cpucount = TIM1->CNT;
	 }
	 else	//normal mode
	 {
		 int32_t temp=0;
		 for(int i=8; i<16;i++)
		 {
			 temp += adcbuffer[i];
		 }
		 //convert dc to ac signal
		 insample = (temp<<1)-32767;

		 //preprocessing the audio sample
		 q15_t nodcsignal;
		 dst_dcremover_process(dcremover,&insample,&nodcsignal);
		 dst_leveldetector_process(leveldetector,&nodcsignal,&INPUTLEVEL);
		 if(USE_DEBUG_MONITOR)
		 {
			 if(USE_LEVEL_MONITOR)
			 {
				 dst_leveldetector_process(dmon->levelprobe1,&dmon->levelprobes[0],&dmon->levelout[0]);
				 dst_leveldetector_process(dmon->levelprobe2,&dmon->levelprobes[1],&dmon->levelout[1]);
			 }
		 }

		 q15_t noaliasing;
		 antialiasing(&nodcsignal,&noaliasing);

		 if(!tunermode)
		 {
			 //processing the audio sample
			 deepstomp_process(&noaliasing,&outsample);
		 }
		 else
		 {
			tuner_fillnotebins(&noaliasing);
			if(!tuner->audiomute)
				outsample = noaliasing;
			else outsample = 0;
		 }

		 //write the sample to the output
		 temp = (int32_t) outsample + 32767; //convert outsample to dc signal
		 TIM4->CCR1 = (0xff00 & temp)>>8;
		 TIM2->CCR2 = 0xff & temp;
		 cpucount = TIM1->CNT;
	 }

}

void HAL_ADC_ConvHalfCpltCallback(ADC_HandleTypeDef* hadc)
{
	 TIM1->CNT = 0;
	 adccounter++;
	 if(cpucount > MAXPROCESSINGCOUNT) //CPU overload is detected on previous processing
	 {
		 cpucount = 0;
		 cpuoverload = 1;
		 return;
	 }

	 if(CALIBRATIONMODE)	//adc calibration mode
	 {
		 int32_t temp=0;
		 for(int i=0; i<8;i++)
		 {
			 temp += adcbuffer[i];
		 }

		 //record the sum of both single and multi-channel
		 caldata->onechannelsample = (((uint32_t)adcbuffer[0]) << 3);
		 caldata->onechannelsum += caldata->onechannelsample;
		 caldata->allchannelsample = temp;
		 caldata->allchannelsum += caldata->allchannelsample;

		 //run calibration display
		 runcalibrationdisplay();

		 //write calibration signal to the output
		 temp = (int32_t) generatecalsignal();
		 TIM4->CCR1 = (0xff00 & temp)>>8;
		 TIM2->CCR2 = 0xff & temp;
		 cpucount = TIM1->CNT;
	 }
	 else	//normal mode
	 {
		 int32_t temp=0;
		 for(int i=0; i<8;i++)
		 {
			 temp += adcbuffer[i];
		 }
		 //convert dc to ac signal
		 insample = (temp<<1)-32767;

		 //pre-processing the audio sample

		 q15_t nodcsignal;
		 dst_dcremover_process(dcremover,&insample,&nodcsignal);
		 dst_leveldetector_process(leveldetector,&nodcsignal,&INPUTLEVEL);
		 if(USE_LEVEL_MONITOR)
		 {
			 dst_leveldetector_process(dmon->levelprobe1,&dmon->levelprobes[0],&dmon->levelout[0]);
			 dst_leveldetector_process(dmon->levelprobe2,&dmon->levelprobes[1],&dmon->levelout[1]);
		 }
		 q15_t noaliasing;
		 antialiasing(&nodcsignal,&noaliasing);

		 if(!tunermode)
		 {
			 //processing the audio sample
			 deepstomp_process(&noaliasing,&outsample);
		 }
		 else
		 {
			tuner_fillnotebins(&noaliasing);
			if(!tuner->audiomute)
				outsample = noaliasing;
			else outsample = 0;
		 }

		 //write the sample to the output
		 temp = (int32_t) outsample + 32767; //convert outsample to dc signal
		 TIM4->CCR1 = (0xff00 & temp)>>8;
		 TIM2->CCR2 = 0xff & temp;
		 cpucount = TIM1->CNT;
	 }
}


void HAL_UART_TxCpltCallback (UART_HandleTypeDef * huart)
{
	if(huart == &huart1)
	{
		if(USE_DEBUG_MONITOR)
			dmon->serialtxcomplete = 1;
	}
}

void createleveprobe(char* buff,q15_t level,char* label)
{
	strncpy(buff,label,2);
	buff[2]=':';
	uint8_t x = level/819;
	for(uint8_t i=3;i<43;i++)
	{
		if((i-3) > x)
			buff[i]= ' ';
		else buff[i]= '#';
	}
	snprintf(&buff[43],8," %5d",(int)level);
}

uint16_t readcalinput()
{
	uint32_t temp=0;
	for(int i=0; i<32; i++)
	{
		HAL_ADC_Start(&hadc2);
		if(HAL_ADC_PollForConversion(&hadc2,10)==HAL_OK)
			temp += HAL_ADC_GetValue(&hadc2);
		HAL_ADC_Stop(&hadc2);
	}
	return temp>>5;
}

void calibratepwm()
{
		TIM4->ARR=256;
		TIM2->ARR=256;
		while(1)
		{
			  calibcount++;
			  if(calibcount>50)
				  break;
			  TIM4->CCR1 = 1;
			  TIM2->CCR2 = 0;
			  HAL_Delay(1);
			  uint16_t prevlevel = readcalinput();
			  histep=0;
			  lostep=0;
			  for(int a=1; a<14; a++)
			  {
				  TIM4->CCR1 = a+1;
				  TIM2->CCR2 = 0;
				  HAL_Delay(1);
				  uint16_t currentlevel = readcalinput();
				  histep += currentlevel-prevlevel;

				  TIM4->CCR1 = a;
				  TIM2->CCR2 = 0xff;
				  HAL_Delay(1);
				  lostep += readcalinput()-prevlevel;

				  prevlevel = currentlevel;
			  }

			  histep = histep/13;
			  lostep = lostep/13;

			  //predict lostep update if the difference is too large
			  if((lostep-histep)>10)
			  {
				  float newarr = (float)lostep/(float)histep * (float)TIM2->ARR;
				  TIM2->ARR = round(newarr);
			  }

			  if(lostep>=histep)
				  TIM2->ARR = TIM2->ARR+1;
			  else if(lostep < (histep-1))
				  TIM2->ARR = TIM2->ARR-1;
			  else break;
		}
}

uint8_t barstate[10];
enum {barchannel_input,barchannel_param,barchannel_presettostore,barchannel_button,
	barchannel_tuner};
uint8_t bardisplaychannel = barchannel_input;

uint8_t const semitonemainled[] = {0,0,1,1,2,3,3,4,4,5,5,6};
uint8_t const semitoneauxled[] = {0,1,1,2,2,3,4,4,5,5,6,6};

void displaybar(int8_t level, uint8_t levelcount, uint8_t type)
{
	if(levelcount<11)
	{
		if(type==dsdisplaytype_bar)
		{
			for(int i=0;i<10;i++)
			{
				if(i>level)
					barstate[i]=0;
				else barstate[i]=2;
			}
		}
		else
		if(type==dsdisplaytype_blinkbar)
		{
			for(int i=0;i<10;i++)
			{
				if(i>level)
					barstate[i]=0;
				else barstate[i]=1;
			}
		}
		else if(type==dsdisplaytype_blinkdot)
		{
			for(int i=0;i<10;i++)
			{
				if(i==level)
					barstate[i]=1;
				else barstate[i]=0;
			}
		}
		else	//dot type
		{
			for(int i=0;i<10;i++)
			{
				if(i==level)
					barstate[i]=2;
				else barstate[i]=0;
			}
		}
	}
	else if(levelcount<20)
	{
		uint8_t halflevel = level/2;
		for(int i=0;i<10;i++)
		{
			if(type==dsdisplaytype_bar)
			{
				for(int i=0;i<10;i++)
				{
					if(i <= halflevel)
						barstate[i]=2;
					else if((halflevel+(level%2))==i)
					{
						barstate[i]=1;
					}
					else barstate[i]=0;
				}
			}
			if(type==dsdisplaytype_blinkdot)	//blinkdot type
			{
				for(int i=0;i<10;i++)
				{
					if(i < halflevel)
						barstate[i]=0;
					else if(i == halflevel)
						barstate[i]=1;
					else if((halflevel+(level%2))==i)
					{
						barstate[i]=1;
					}
					else barstate[i]=0;
				}
			}
			else	//dot type
			{
				for(int i=0;i<10;i++)
				{
					if(i < halflevel)
						barstate[i]=0;
					else if(i == halflevel)
						barstate[i]=2;
					else if((halflevel+(level%2))==i)
					{
						barstate[i]=2;
					}
					else barstate[i]=0;
				}
			}
		}
	}
	else	//levelcount > 20
	{
		if(type==dsdisplaytype_semitones)
		{
			//truncate the possible level violation
			if(level>35) level = 35;

			//LED0, LED1, LED2, LED3, LED4, LED5, LED6 = C D E F G A B
			//= NOTE0, NOTE2, NOTE4, NOTE5, NOTE7, NOTE9, NOTE11
			uint8_t note = level%12;

			//LED7, LED8, LED9 = OCTAVE0, OCTAVE1, OCTAVE2
			uint8_t octave = level/12;

			for(int i=0; i<10;i++)
				barstate[i] = 0;
			barstate[semitonemainled[note]]=2;
			barstate[semitoneauxled[note]]=2;
			barstate[7+octave]=1;
		}
		else	//all other types will br displayed as dot and blinking dot combination
		{
			uint8_t quarterlevel = level/4;
			uint8_t remainder = level%4;
			for(int i=0;i<10;i++)
			{
				if(i==quarterlevel)
				{
					if((remainder==0||(remainder==1)||remainder==2))
						barstate[i]=2;
					else if(remainder==3)
						barstate[i]=1;
					else barstate[i]=0;
				}
				else if(i==(quarterlevel+1))
				{
					if((remainder==2)||(remainder==3))
						barstate[i]=2;
					else if(remainder==1)
						barstate[i]=1;
					else barstate[i]=0;
				}
				else barstate[i]=0;
			}
		}
	}
}

uint8_t animatebar_state = 0;
uint32_t animatebar_prevtick = 0;
uint32_t animatebar_currtick = 0;
void animatebar()
{
	animatebar_currtick = HAL_GetTick();
	  if(animatebar_currtick-animatebar_prevtick<100)
		  return;
	  animatebar_prevtick = animatebar_currtick;
	  RUNTIME = animatebar_currtick/1000;

	  //select channel
	  if(bardisplaychannel == barchannel_input)
	  {
		  if(cpuoverload)
		  {
			  cpuoverload = 0;
			  cpuoverloadcounter = 10;
		  }

		  if(cpuoverloadcounter)
		  {
			  cpuoverloadcounter--;
			  displaybar(9,10,dsdisplaytype_blinkdot);
			  cpuoverload = 0;
		  }
		  else
		  {
			  displaybar(INPUTLEVEL/3276,10,dsdisplaytype_bar);
		  }
	  }
	  else if(bardisplaychannel == barchannel_param)
	  {
		  int8_t templevel = PARAMS[paramindex]->value;
		  displaybar(templevel, PARAMS[paramindex]->stepcount,dsdisplaytype_dot);
	  }
	  else if(bardisplaychannel == barchannel_presettostore)
	  {
		  int8_t templevel = presettostore;
		  displaybar(templevel, 19 ,dsdisplaytype_blinkdot);
	  }
	  else if(bardisplaychannel == barchannel_button)
	  {
		  //?
	  }
	  else if(bardisplaychannel == barchannel_tuner)
	  {
		  displaybar(tuner->detectednote, 36 ,dsdisplaytype_semitones);
	  }

	  for(int i=0;i<10;i++)
	  {
		  if(barstate[i]==0)
		  {
			  HAL_GPIO_WritePin((GPIO_TypeDef*)ledbarport[i],ledbarpin[i],0);
		  }
		  else if(barstate[i]==1)
		  {
			  if(animatebar_state)
				  HAL_GPIO_WritePin((GPIO_TypeDef*)ledbarport[i],ledbarpin[i],1);
			  else HAL_GPIO_WritePin((GPIO_TypeDef*)ledbarport[i],ledbarpin[i],0);
		  }
		  else HAL_GPIO_WritePin((GPIO_TypeDef*)ledbarport[i],ledbarpin[i],1);
	  }
	  if(animatebar_state)
		  animatebar_state = 0;
	  else animatebar_state = 1;
}

uint8_t animateindi_state = 0;
uint32_t animateindi_prevtick = 0;
uint32_t animateindi_currtick = 0;

enum {blinkselect,blinkedit,blinknone};
int8_t indiblinktype = blinkselect;
uint8_t indiblinkindex = 0;
int8_t indiblinkoncounter = 0;
int8_t blinkon = 1;
void indiblink()
{
	animateindi_currtick = HAL_GetTick();
	  if(animateindi_currtick-animateindi_prevtick<100)
		  return;
	  animateindi_prevtick = animateindi_currtick;

	  if(indiblinktype==blinknone)
	  {
		  indiblinkoncounter = 0;
		  for(int i = 0;i<6;i++)
		  {
			  HAL_GPIO_WritePin((GPIO_TypeDef*)ledindiport[i],ledindipin[i],ledindibuttonstate[i]);
		  }
	  }
	  else  if(indiblinktype==blinkselect)
	  {
		  for(int i = 0;i<6;i++)
		  {
			  HAL_GPIO_WritePin((GPIO_TypeDef*)ledindiport[i],ledindipin[i],0);
		  }
		  HAL_GPIO_WritePin((GPIO_TypeDef*)ledindiport[indiblinkindex],ledindipin[indiblinkindex],1);
	  }
	  else	//blinkedit
	  {
		  for(int i = 0;i<6;i++)
		  {
			  HAL_GPIO_WritePin((GPIO_TypeDef*)ledindiport[i],ledindipin[i],0);
		  }
		  if(blinkon)
		  {
			  HAL_GPIO_WritePin((GPIO_TypeDef*)ledindiport[indiblinkindex],ledindipin[indiblinkindex],1);
			  blinkon = 0;
		  }
		  else
		  {
			  blinkon = 1;
		  }

	  }

}

void indishowselect(uint8_t index)
{
	indiblinktype = blinkselect;
	indiblinkindex = index;
}

void indishowedit(uint8_t index)
{
	indiblinktype = blinkedit;
	indiblinkindex = index;
}

void indishowbutton()
{
	indiblinktype = blinknone;
}

int8_t prevparamvalue;
void on_editenter()
{
	prevparamvalue = *rotatedindex;
}

void on_editexit()
{
	int dowrite  = 0;
	if(prevparamvalue != (*rotatedindex))
	{
		//copy all params values to parambuffer
		for(int i=0;i<((dstinterface*)MAINMODULE)->paramcount;i++ )
		{
			storagebuffer->params[i] = PARAMS[i]->value;
		}

		if(((dstinterface*)MAINMODULE)->multimode)
		{
			//copy all modules param value to the active setting (preset[19])
			dstmultimodule* hmm = (dstmultimodule*) MAINMODULE;
			preset* presetptr = (preset*) storagebuffer->presetbuffer;
			for(int i=0; i< hmm->module.stepcount; i++)
			{
				dstsinglemodule* hsm = (dstsinglemodule*) hmm->modulehandles[i];
				for(int p = 0; p <hsm->interface.paramcount; p++)
				{
					if(p>3)
						break;
					presetptr->preset[19].module[i].control[p] = hsm->params[p].value;
				}
			}

		}

		dowrite = 1;
	}
	//if exit status is to store the active setting to the preset
	//then save all module setting to the current preset
	if(((dstinterface*)MAINMODULE)->multimode)
	{
		dstmultimodule* hmm = (dstmultimodule*) MAINMODULE;
		preset* presetptr = (preset*) storagebuffer->presetbuffer;

		if((EDITEXITSTATUS == editexit_storepresetclick) && (paramindex == 5))
		{
			for(int i=0; i< hmm->module.stepcount; i++)
			{
				dstsinglemodule* hsm = (dstsinglemodule*) hmm->modulehandles[i];

				for(int p = 0; p <hsm->interface.paramcount; p++)
				{
					if(p>3)
						break;
					presetptr->preset[presettostore].module[i].control[p] =
							presetptr->preset[19].module[i].control[p] ;
				}
			}

			//change the last accessed preset to the stored preset
			hmm->preset.value = presettostore;

			dowrite=1;
		}

		//if long press on preset selector then reset the selected preset to default
		//then reset all module's controls with the default
		if((EDITEXITSTATUS == editexit_storepresetlongpress) && (paramindex == 5))
		{
			for(int i=0; i< hmm->module.stepcount; i++)
			{
				dstsinglemodule* hsm = (dstsinglemodule*) hmm->modulehandles[i];

				for(int p = 0; p <hsm->interface.paramcount; p++)
				{
					if(p>3)
						break;
					presetptr->preset[presettostore].module[i].control[p] =
							DEFAULTPRESET[presettostore][i][p];
					hsm->params[p].onchange((dsthandle) hsm, DEFAULTPRESET[presettostore][i][p]);
				}
			}
			//change the last accessed preset to the restored preset
			hmm->preset.value = presettostore;
			dowrite=1;
		}
	}
	if(dowrite)
		writetostorage();
}

//parameters edit menu
enum {menustate_start,menustate_waittrigger, menustate_rotateparamselect,
		menustate_editparamvalue,menustate_selectpresettostore,
		menustate_runtunner};
uint8_t menustate = menustate_start;
uint32_t menu_currtick = 0;
uint32_t menu_prevtick = 0;
void menu()
{
	menu_currtick = HAL_GetTick();
	if(menu_currtick-menu_prevtick<50)
		return;
	menu_prevtick = menu_currtick;

	if(menustate==menustate_start)
	{
		indishowbutton();
		bardisplaychannel = barchannel_input;
		rotatetrigger = 0;
		longpresstrigger = 0;
		briefpresstrigger = 0;
		rotencode_state = rotencode_startwaittrigger;
		menustate=menustate_waittrigger;
		rotate_editparam = 0;
		cpuoverload = 0;
		cpuoverloadcounter = 0;
	}
	else if(menustate==menustate_waittrigger)
	{
		if(rotatetrigger)
		{
			bardisplaychannel = barchannel_param;
			rotatedindex = &paramindex;
			rotatedindexmax=5;
			rotencode_state = rotencode_startrun;
			rotateexit = rotateexit_notyet;
			menustate = menustate_rotateparamselect;
		}
		else if(longpresstrigger)
		{
			//activate the tuner mode
			tunermode = 1;
			tuner->run_state = tuner_runstate_start;

			//menustate = runtunner
			menustate = menustate_runtunner;
			longpresstrigger = 0;
			briefpresstrigger = 0;
			rotatetrigger = 0;
			rotencode_state = rotencode_startwaittrigger;

			indiblinktype = blinknone;
			bardisplaychannel = barchannel_tuner;

		}
		else if(briefpresstrigger) //briefpresstrigger
		{
			menustate=menustate_start;
		}
	}
	else if(menustate==menustate_runtunner)
	{
		if(longpresstrigger)
		{
			//deactivate tunner mode
			tunermode = 0;

			for(int i=0;i<6;i++)
				ledindibuttonstate[i]=0;
			menustate=menustate_start;

		}
		else if(briefpresstrigger)
		{
			//toggle tunner bypass mode
			//{}
			briefpresstrigger = 0;
			rotencode_state = rotencode_startwaittrigger;
			if(tuner->audiomute)
			{
				tuner->audiomute = 0;
				tuner->detectednote = 24;
			}
			else
			{
				tuner->audiomute = 1;
				tuner->detectednote = 12;
			}
		}
		else if(rotatetrigger)
		{
			//do nothing, restart waiting trigger
			rotatetrigger = 0;
			rotencode_state = rotencode_startwaittrigger;
		}

	}
	else if(menustate==menustate_rotateparamselect)
	{
		indishowselect(paramindex);
		if(rotateexit == rotateexit_click)
		{
			rotatedindex = &(PARAMS[paramindex]->value);
			rotatedindexmax= PARAMS[paramindex]->stepcount-1;
			ROTATE_CALLBACK = PARAMS[paramindex]->onchange;
			dstmultimodule * mm = (dstmultimodule *) MAINMODULE;
			if(mm->interface.multimode)	//multi-effect mode
			{
				if(paramindex < 4)	//controls is selected
					ROTATEDMODULE = SUBMODULE;
				else	//preset or module selector is selected
					ROTATEDMODULE = MAINMODULE;
			}
			else 	//single-effect mode
			{
				ROTATEDMODULE = MAINMODULE;
			}
			rotencode_state = rotencode_startrun;
			rotateexit = rotateexit_notyet;
			menustate = menustate_editparamvalue;
			rotate_editparam = 1;
			indishowedit(paramindex);
			on_editenter();
		}
		if(rotateexit == rotateexit_longpress)
		{
			dstmultimodule * mm = (dstmultimodule *) MAINMODULE;
			if(mm->interface.multimode)	//multi-effect mode
			{
				if(paramindex == 5) //the preset selector
				{
					menustate= menustate_selectpresettostore;
					presettostore = PARAMS[5]->value;
					rotatedindex = &presettostore;
					ROTATE_CALLBACK = NULL;
					rotatedindexmax = 18;
					rotate_editparam = 1;
					rotateexit = rotateexit_notyet;
					rotencode_state = rotencode_startrun;
					bardisplaychannel = barchannel_presettostore;
					indishowbutton();
				}
				else //not the preset selector then long press = cancel
				{
					menustate=menustate_start;
				}

			}
			else	//single-effect mode then long press = cancel
			{
				menustate=menustate_start;
			}
		}
		else if(rotateexit == rotateexit_expired)
		{
			menustate=menustate_start;
		}
	}
	else if(menustate==menustate_editparamvalue)
	{
		if(rotateexit == rotateexit_expired)
		{
			EDITEXITSTATUS = editexit_expired;
			on_editexit();
			menustate=menustate_start;
		}
		else if(rotateexit == rotateexit_click)
		{
			EDITEXITSTATUS = editexit_click;
			on_editexit();
			menustate=menustate_start;
		}
		else if(rotateexit == rotateexit_longpress)
		{
			EDITEXITSTATUS = editexit_longpress;
			on_editexit();
			menustate=menustate_start;
		}
	}
	else if(menustate==menustate_selectpresettostore)
	{
		if(rotateexit == rotateexit_expired)
		{
			EDITEXITSTATUS = editexit_storepresetexpired;
			on_editexit();
			menustate=menustate_start;
		}
		else if(rotateexit == rotateexit_click)
		{
			EDITEXITSTATUS = editexit_storepresetclick;
			on_editexit();
			menustate=menustate_start;
		}
		else if(rotateexit == rotateexit_longpress)
		{
			EDITEXITSTATUS = editexit_storepresetlongpress;
			on_editexit();
			menustate=menustate_start;
		}
	}
}

static int8_t multieffectpresetchange(dsthandle handle, int8_t newvalue)
{
	dstmultimodule* hmm = (dstmultimodule*) handle;

	for(int i=0; i< hmm->module.stepcount; i++)
	{
		dstsinglemodule* hsm = (dstsinglemodule*) hmm->modulehandles[i];
		//load all parameter from the presetbuffer
		for(int p = 0; p <hsm->interface.paramcount; p++)
		{
			if(p>3)
				break;
			int8_t data = PRESETBUFFER->preset[newvalue].module[i].control[p];
			hsm->params[p].onchange((dsthandle)hsm,data);
		}
	}
	hmm->preset.value = newvalue;
	return newvalue;
}

static int8_t multieffectmodulechange(uint32_t handle, int8_t newvalue)
{
	//find the number of parameter of the current module
	dstmultimodule* hmm = (dstmultimodule*) handle;
	hmm->module.value = newvalue;
	dstsinglemodule* hsm = hmm->modulehandles[newvalue];

	SUBMODULE = (dsthandle) hsm;
	//assign the module's parameter to the control (only the first 4 parameters)
	for(int i=0;i < 4 ;i++)
	{
		if(i < hsm->interface.paramcount)
			PARAMS[i] = &(hsm->params[i]);
		else PARAMS[i] = &paramdump;
	}
	return newvalue;
}

static uint16_t generatecalsignal()
{
	if(caldata->calsignalstate)
	{
		caldata->calsignalcurrlevel += calsignalstep;
		if(caldata->calsignalcurrlevel >= maxcalsignallevel)
		{
			caldata->calsignalstate = 0;
		}
	}
	else
	{
		caldata->calsignalcurrlevel -= calsignalstep;
		if(caldata->calsignalcurrlevel <= mincalsignallevel)
		{
			caldata->calsignalstate = 1;
		}
	}
	return caldata->calsignalcurrlevel;
}

/* USER CODE END 0 */

/**
  * @brief  The application entry point.
  *
  * @retval None
  */
int main(void)
{
  /* MCU Configuration----------------------------------------------------------*/

  /* Reset of all peripherals, Initializes the Flash interface and the Systick. */
  HAL_Init();

  /* Configure the system clock */
  SystemClock_Config();

  /* Initialize all configured peripherals */
  MX_GPIO_Init();
  MX_DMA_Init();
  MX_ADC1_Init();
  MX_ADC2_Init();
  MX_TIM3_Init();
  MX_USART1_UART_Init();
  MX_TIM4_Init();
  MX_TIM2_Init();
  MX_TIM1_Init();
  /* USER CODE BEGIN 2 */

	//create and initialize signal preprocessors
	leveldetector = dst_leveldetector_create(4410);	//create level detector for 1/10 second sampling window
	dcremover = dst_dcremover_create();
	initantialiasing();

	//ADC calibration
	  HAL_ADCEx_Calibration_Start(&hadc1);
	  HAL_ADCEx_Calibration_Start(&hadc2);

	//start PWM
	HAL_TIM_PWM_Start(&htim2,TIM_CHANNEL_2);
	HAL_TIM_PWM_Start(&htim4,TIM_CHANNEL_1);


	/*
	 * //Uncomment to test all PARAMS LEDs and BAR LEDs
	 * #######################################################################
	//begin LED test
	while(1)
	{
		for(int i=0;i<5;i++)
		{
			HAL_GPIO_WritePin((GPIO_TypeDef*)ledindiport[0],ledindipin[0],1);
			HAL_Delay(100);
			HAL_GPIO_WritePin((GPIO_TypeDef*)ledindiport[0],ledindipin[0],0);
			HAL_Delay(100);

		}

		for(int i=0;i<6;i++)
		{
			HAL_GPIO_WritePin((GPIO_TypeDef*)ledindiport[i],ledindipin[i],1);
			HAL_Delay(500);
			HAL_GPIO_WritePin((GPIO_TypeDef*)ledindiport[i],ledindipin[i],0);
		}
		for(int i=0;i<10;i++)
		{
			HAL_GPIO_WritePin((GPIO_TypeDef*)ledbarport[i],ledbarpin[i],1);
			HAL_Delay(500);
			HAL_GPIO_WritePin((GPIO_TypeDef*)ledbarport[i],ledbarpin[i],0);
		}
	}
	//end LED test
	*/

	//Auto calibrate 16-bit PWM DAC
	calibratepwm();
	 //error blink: too long calibration trial
	  if(calibcount>100)
		  errorblink(ERR_TOO_MANY_CAL_TRIALS);
	//error blink: too low resistor value
	  if(TIM2->ARR < 257)
		  errorblink(ERR_TOO_LOW_RESISTOR);
	  //error blink: too high resistor value
	  if(TIM2->ARR > 350)
		  errorblink(ERR_TOO_HIGH_RESISTOR);

	//init blank param
	paramdump.onchange=NULL;
	paramdump.stepcount=1;
	paramdump.value = 0;
	paramdump.displaytype = displaytype_bar10;

	//allocate storage buffer
	storagebuffer =(storagestruct*)malloc(1024);
	if(storagebuffer==NULL)
		errorhalt(ERR_STORAGE_ALLOCATION);

	// run module's setup
	if(deepstomp_modulesetup()!=setup_ok)
	{
		errorhalt(ERR_MODULE_SETUP);
	}

	//Detect if the rotary switch is pressed and held at power-on
	if(readrotsw())
	{
	  CALIBRATIONMODE = 0;
	  //load params and preset data from flash memory storage
	  	loadfromstorage();

	  	//configure the core's user interface
	  	if(((dstinterface*)MAINMODULE)->multimode)	//if a multi-effect mode
	  	{
	  		dstmultimodule* h= (dstmultimodule*) MAINMODULE;

	  		//assign the PRESETBUFFER pointer with the allocated storage, and initialize to default if not set
	  		PRESETBUFFER = (preset*) storagebuffer->presetbuffer;
	  		for(int p=0; p<h->preset.stepcount;p++)
	  		{
	  			for(int m=0;m<h->module.stepcount;m++)
	  			{
	  				for(int par=0; par < h->modulehandles[m]->interface.paramcount;par++)
	  				{
	  					if(par>3)	//manage only the first 4 parameters
	  						break;
	  					if(PRESETBUFFER->preset[p].module[m].control[par] < 0)	//not set (after mass erase on firmware programming)
	  						PRESETBUFFER->preset[p].module[m].control[par] = DEFAULTPRESET[p][m][par];
	  				}
	  			}
	  		}

	  		//setup last active preset[19]
	  		for(int m=0;m<h->module.stepcount;m++)
	  		{
	  			for(int par=0; par < h->modulehandles[m]->interface.paramcount;par++)
	  			{
	  				if(par>3)	//manage only the first 4 parameters
	  					break;
	  				if(PRESETBUFFER->preset[19].module[m].control[par] < 0)	//not set (after mass erase on firmware programming)
	  					PRESETBUFFER->preset[19].module[m].control[par] = DEFAULTPRESET[19][m][par];
	  			}
	  		}

	  		//module and preset control setup
	  		h->module.onchange = multieffectmodulechange;
	  		h->preset.onchange = multieffectpresetchange;
	  		PARAMS[4] = &(h->module);
	  		PARAMS[5] = &(h->preset);
	  		//set the active module and preset from the last saved states
	  		int preset = storagebuffer->params[5];
	  		int module = storagebuffer->params[4];
	  		if(storagecounter < 1)
	  		{
	  			preset = 0;
	  			module = 0;
	  		}
	  		h->module.onchange((dsthandle)h,module);

	  		//if not the first use (after flash erase on the first firmware upload)
	  		if(storagecounter > 0)
	  		{
	  			h->preset.value = preset;	//set the preset without actually setting up any modules
	  			//load the module with the last active setting (preset[19]) which could have
	  			//the same or different  values with the last selected preset
	  			for(int i=0; i< h->module.stepcount; i++)
	  			{
	  				dstsinglemodule* hsm = (dstsinglemodule*) h->modulehandles[i];
	  				//load all parameter from the presetbuffer
	  				for(int p = 0; p <hsm->interface.paramcount; p++)
	  				{
	  					if(p>3)
	  						break;
	  					int8_t data = PRESETBUFFER->preset[19].module[i].control[p];
	  					hsm->params[p].onchange((dsthandle)hsm,data);
	  				}
	  			}
	  		}
	  		else
	  		{
	  			h->preset.onchange((dsthandle)h,preset);
	  		}
	  	}
	  	else	//single effect mode
	  	{
	  		dstsinglemodule* h = (dstsinglemodule*) MAINMODULE;
	  		int8_t* paramptr = storagebuffer->params;

	  		for(int p=0; p<6 ; p++)
	  		{
	  			if(p < h->interface.paramcount)
	  			{
	  				PARAMS[p] = &(h->params[p]);
	  				//if not the first run (flash erase on firmware upload)
	  				//then load the param with the last saved value from storage
	  				if(storagecounter > 0)
	  					PARAMS[p]->onchange((dsthandle)h,paramptr[p]);
	  			}
	  			else PARAMS[p] = &paramdump;
	  		}
	  	}
	}
	else
	{
		CALIBRATIONMODE = 1;
	}

	//initialize debug monitor
	if(USE_DEBUG_MONITOR)
	{
		int res = debugmonitor_init();
		if(res)
			errorblink(res);
	}

	//calibration initialization
	if(CALIBRATIONMODE)
		adccal_init();

	//initialize instrument tuner
	tuner_init();

	//start timer 1: cpu cycle counter
	HAL_TIM_Base_Start(&htim1);

	//START AUDIO ADC
	TIM3->ARR = 1632;	//44.1kHz sampling rate
	HAL_TIM_Base_Start(&htim3);
	HAL_ADC_Start_DMA(&hadc1,(uint32_t*)adcbuffer,16);

  /* USER CODE END 2 */

  /* Infinite loop */
  /* USER CODE BEGIN WHILE */

	//if rotary switch id pressed while powering-up
	//then enter calibration operation for the ADC
	if(CALIBRATIONMODE)
	{
		while(1)
		{
			if(USE_DEBUG_MONITOR)
			{
				debugmonitor_run();
			}
		}
	}
	else //enter normal operation mode
	{
	  while (1)
	  {
			  menu();
			  animatebar();
			  rotscan();
			  rotencode();
			  indiblink();
			  runstoragewrite();
			  if(tunermode)
				  tuner_run();
			  if(USE_DEBUG_MONITOR)
			  {
				  debugmonitor_run();
			  }

  /* USER CODE END WHILE */

  /* USER CODE BEGIN 3 */

	  }
	}
  /* USER CODE END 3 */

}

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
