hamuro80/deepstomp/(commit log)

2018-12-21 First uploading SW4STM32 project files
    [deepstomp Run.cfg]
2018-12-21 Reorganizing SW4STM32 project files
    [deepstomp Run.cfg]
2018-12-22 adding adc calibration process, but not finished yet
    [deepstomp Run.cfg]
2018-12-23 Add schematic diagram and write the readme file
2018-12-28 Changed the preset loading and reset to factory preset
    [deepstomp.c, main.c]
2019-02-01 Update the hardware schematic diagram
2019-02-13 - Modified hardware schematic, now fully tested
2019-03-11 Added bill of material in the readme file of the hardware folder
2019-03-11 Add the missing LEDs in BOM
2019-03-18 Added missing S4 rotary encoder in the bill of materials
2019-04-10 Improved CPU overload detection
    [bluestomp Run.cfg]
2019-04-22 edit the bill of material and schematic
