hamuro80/deepstomp/(notices)

Notices in the files:
software/deepstomp/Src/main.c:
(C) COPYRIGHT STMicroelectronics *****END OF FILE
(C) COPYRIGHT DEEPTRONIC.COM *****END OF FILE
